Tympan/Tympan_AIC_Shield/README.md

# Tympan AIC Shield
## Add a CODEC to your Tympan with this daughter card!

This hardware design is in BETA and will be available for purchase March of 2019 at [Tympan.org](https://tympan.org/)
