Tympan/Tympan_AIC_Shield/Production/Tympan_AIC_Shield_BOM.xlsx

Item | Reference | Package | Quantity | Value | Manufacturer | Part Number | Notes
1 | C23,C2,C8,C12,C13,C24,C25,C26 | C_0402 | 8 | 2.2uF | Murata | GRT155C71A225KE13D
2 | C3,C5,C7,C10,C16,C18 | C_0402 | 6 | 0.1uF | TDK Corporation | C1005X7R1H104K050BB
3 | C4,C6,C11 | C_0402 | 3 | 10uF | Murata | GRM155C80J106ME11J
4 | C9,C17,C19 | C_0402 | 3 | 1uF | Murata | GRM155C81C105KE15D
5 | J1 | SJ-3523-SMT-TR | 1 | Phone Out | CUI Inc | SJ-3523-SMT-TR
6 | J2 | SJ-3524-SMT-TR | 1 | Mic In | CUI Inc | SJ-3524-SMT-TR-PI
7 | MIC2,MIC1 | SPM0687LR5H-1 | 2 | DNP | DNP | DNP | DNP
8 | P5,P6 | Pin_Header_Straight_1x06_Pitch2.54mm | 2 | CONN_01X06 | Samtec | SSW-106-01-G-S
9 | P3,P4,P2,P1 | Pin_Header_Straight_1x06_Pitch2.54mm | 4 | CONN_01X06 | Samtec | SSW-106-03-T-S
10 | R1,R8 | R_0402 | 2 | 4K7 | Yageo | RC0603FR-074K7L
11 | R12,R13 | C_0603 | 2 | 0R | Vishay Dale | CRCW06030000Z0EA
12 | R14,R17 | C_0603 | 2 | DNP | DNP | DNP | DNP
13 | R15,R16 | C_0603 | 2 | 2.2K | Yageo | RC0603FR-072K2L
14 | R2,R3,R4,R5,R6,R7,R9,R10 | R_0402 | 8 | 33R | Yageo | RC0402FR-0733RL
15 | U2 | UQFN-40-1EP_5x5mm_Pitch0.4mm | 1 | CODEC | Texas Instrument | TLV320AIC3206IRSBT
16 | U3 | SOT-353_SC-70-5 | 1 | Analog Switch IC | Texas Instrument | TS5A3166DCKR
