Tympan/Tympan_AIC_Shield/Tympan AIC Shield Schematic.pdf

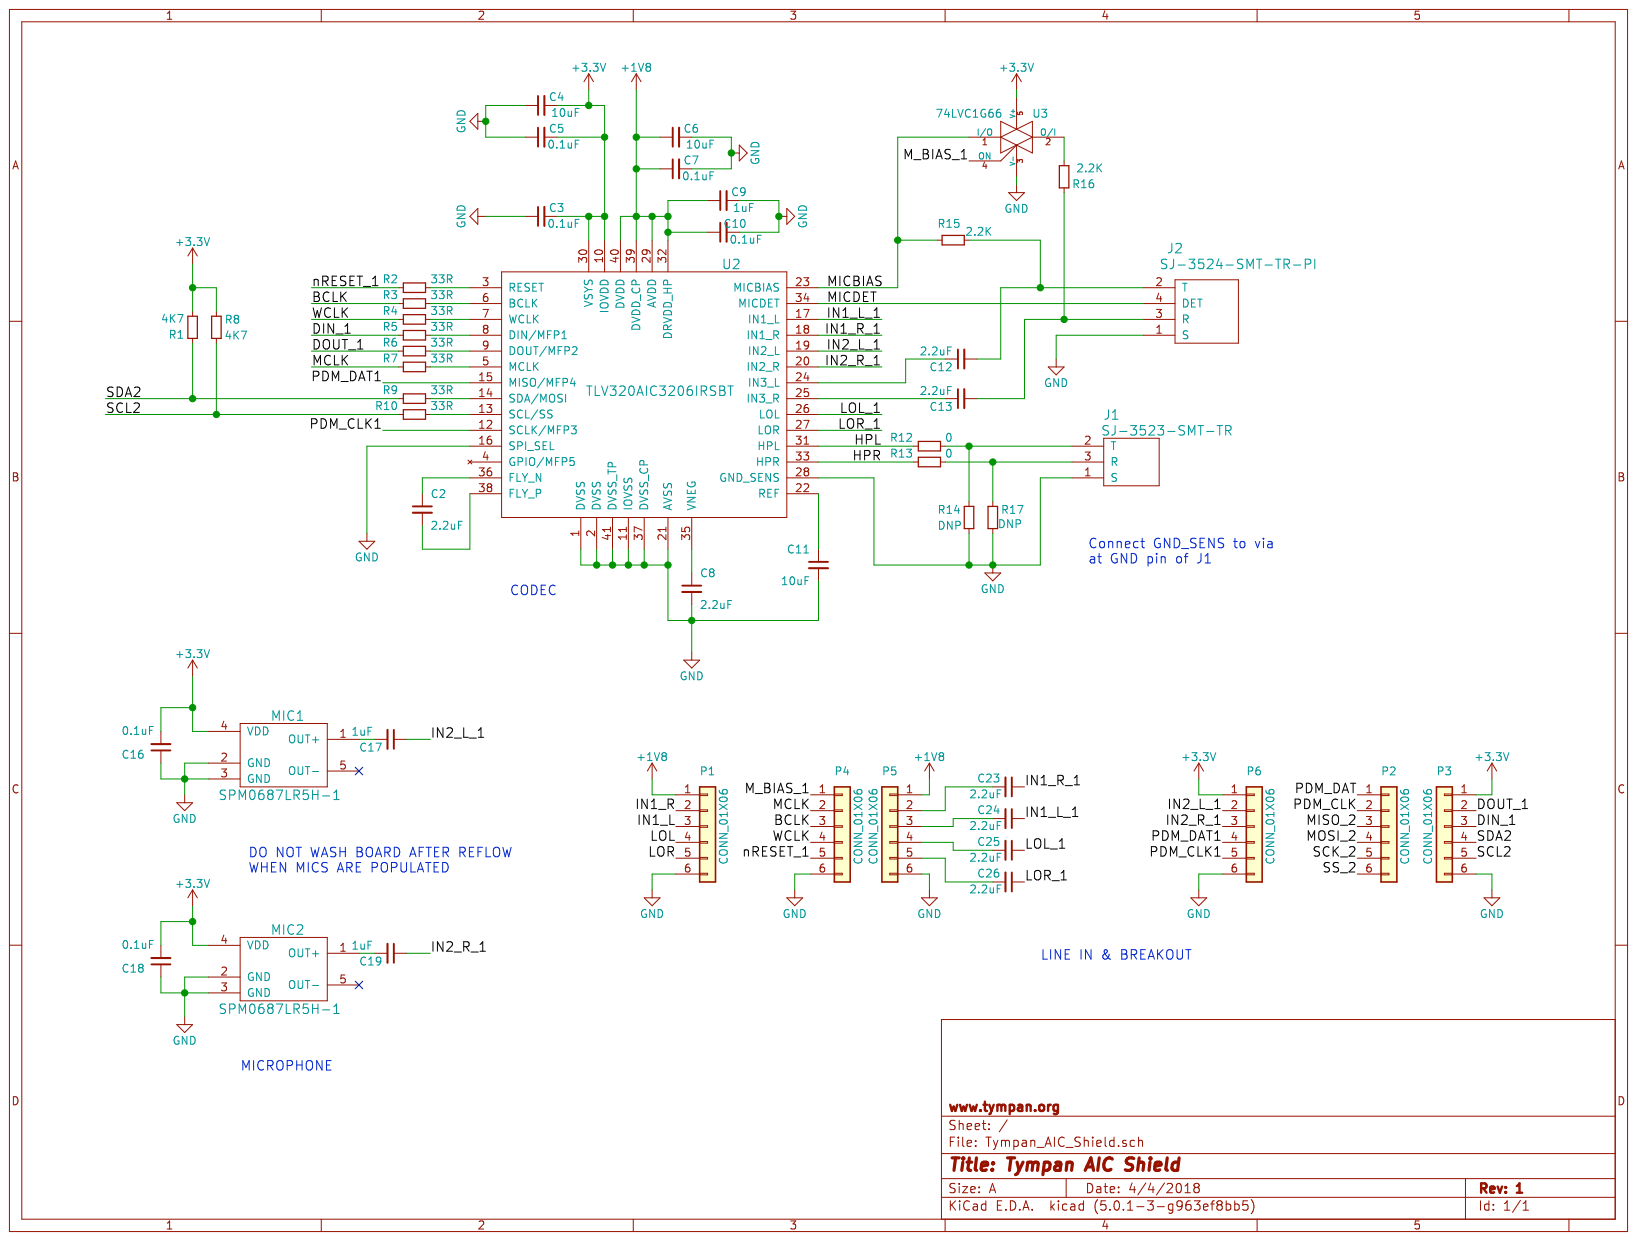
[picture p1: page 1]
