Tympan/Tympan_AIC_Shield/Tympan_AIC_Shield.kicad_pcb

## KiCad design Tympan_AIC_Shield.kicad_pcb (2019-03-19)

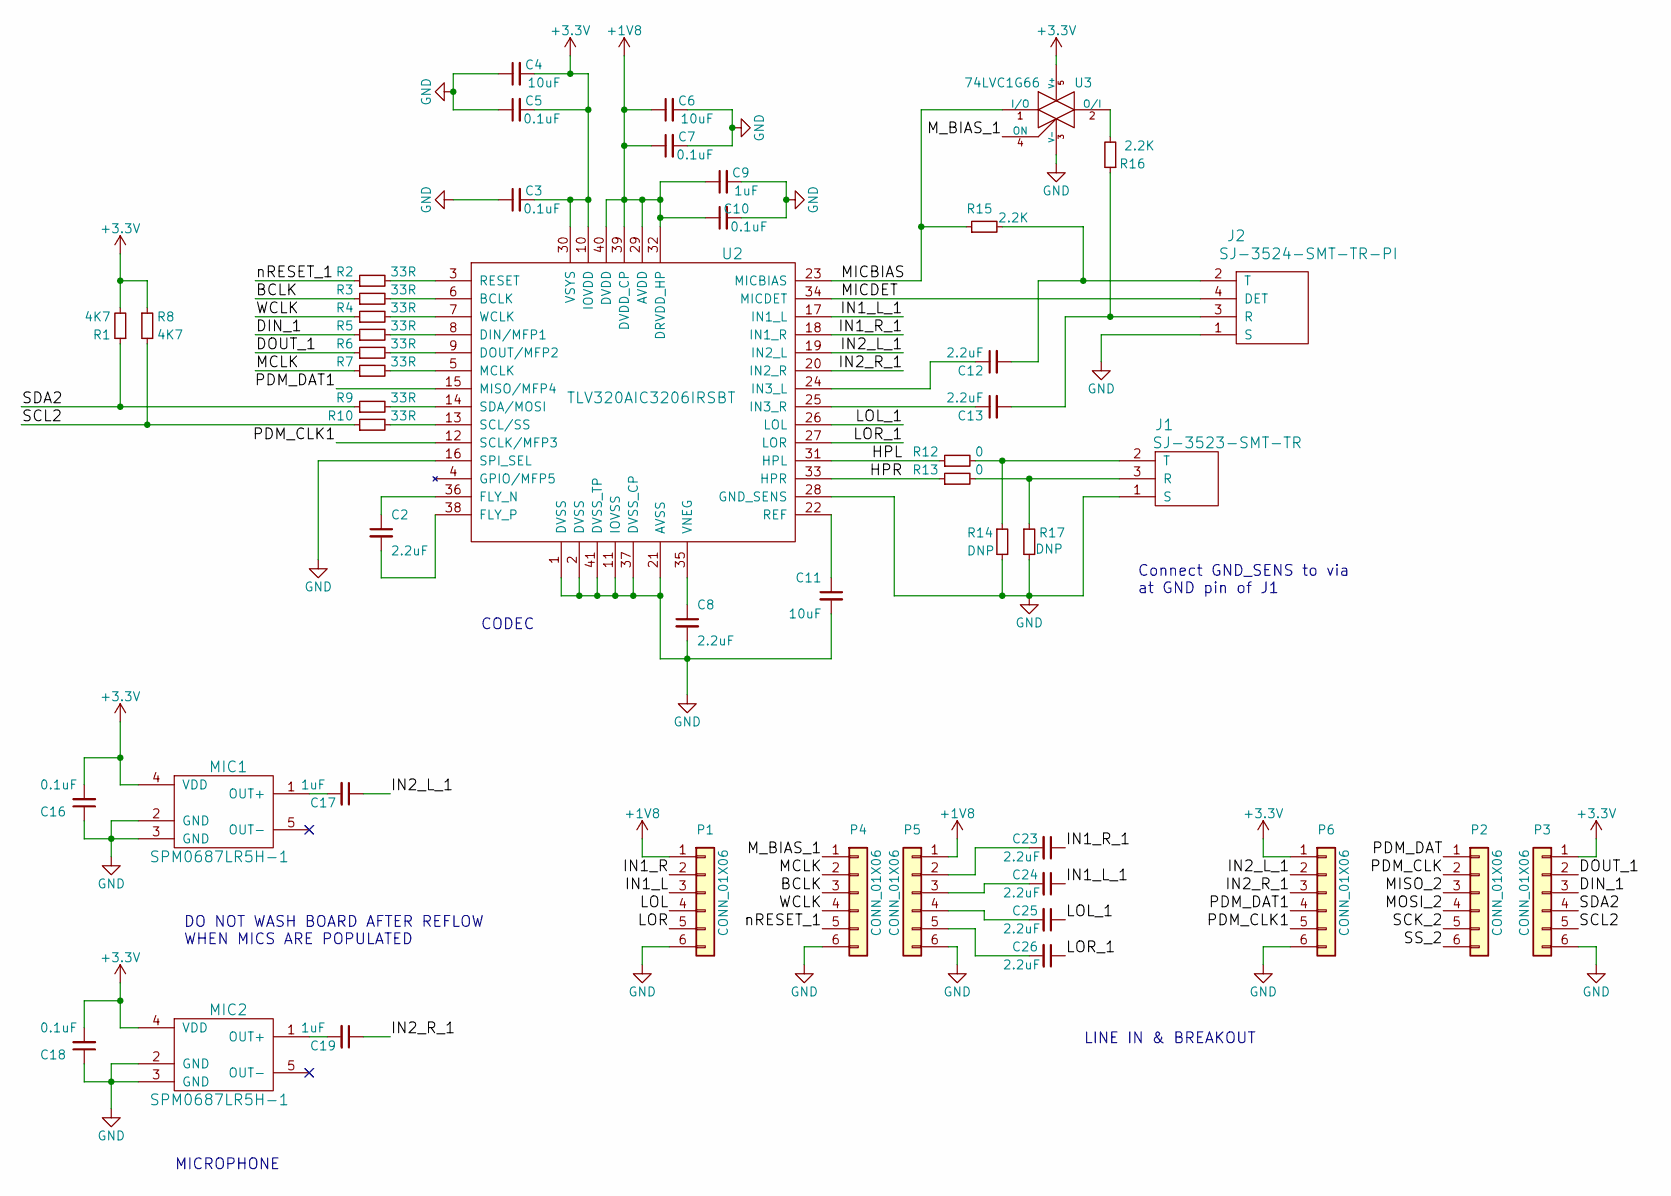
[picture p2: schematic Tympan_AIC_Shield.sch, Tympan AIC Shield]

Parts:
C2, C8, C12, C13, C23, C24, C25, C26: 2.2uF; C_0402
C3, C5, C7, C10, C16, C18: 0.1uF; C_0402
C4, C6, C11: 10uF; C_0402
C9, C17, C19: 1uF; C_0402
J1: SJ-3523-SMT-TR
J2: SJ-3524-SMT-TR-PI; SJ-3524-SMT-TR
MIC1, MIC2: SPM0687LR5H-1
P1, P2, P3, P4, P5, P6: CONN_01X06; Pin_Header_Straight_1x06_Pitch2.54mm
R1, R8: 4K7; R_0402
R2, R3, R4, R5, R6, R7, R9, R10: 33R; R_0402
R12, R13: 0; C_0603
R14, R17: DNP; C_0603
R15, R16: 2.2K; C_0603
U2: TLV320AIC3206IRSBT; UQFN-40-1EP_5x5mm_Pitch0.4mm
U3: 74LVC1G66; SOT-353_SC-70-5

Connections:
+1V8: C6.1, C7.1, C9.1, C10.1, P1.1, P5.1, U2.29 (AVDD), U2.32 (DRVDD_HP), U2.39 (DVDD_CP), U2.40 (DVDD)
+3V3: C3.2, C4.2, C5.2, C16.2, C18.2, MIC1.4 (VDD), MIC2.4 (VDD), P3.1, P6.1, R1.2, R8.1, U2.10 (IOVDD), U2.30 (VSYS), U3.5 (V+)
/BCLK: P4.3, R3.1
/DIN_1: P3.3, R5.1
/DOUT_1: P3.2, R6.1
/HPL: R12.1, U2.31 (HPL)
/HPR: R13.1, U2.33 (HPR)
/IN1_L: P1.3
/IN1_L_1: C24.1, U2.17 (IN1_L)
/IN1_R: P1.2
/IN1_R_1: C23.1, U2.18 (IN1_R)
/IN2_L_1: C17.1, P6.2, U2.19 (IN2_L)
/IN2_R_1: C19.1, P6.3, U2.20 (IN2_R)
/LOL: P1.4
/LOL_1: C25.1, U2.26 (LOL)
/LOR: P1.5
/LOR_1: C26.1, U2.27 (LOR)
/MCLK: P4.2, R7.1
/MICBIAS: R15.1, U2.23 (MICBIAS), U3.1 (I/O)
/MICDET: J2.4 (DET), U2.34 (MICDET)
/MISO_2: P2.3
/MOSI_2: P2.4
/M_BIAS_1: P4.1, U3.4 (ON)
/PDM_CLK: P2.2
/PDM_CLK1: P6.5, U2.12 (SCLK/MFP3)
/PDM_DAT: P2.1
/PDM_DAT1: P6.4, U2.15 (MISO/MFP4)
/SCK_2: P2.5
/SCL2: P3.5, R8.2, R10.1
/SDA2: P3.4, R1.1, R9.1
/SS_2: P2.6
/WCLK: P4.4, R4.1
/nRESET_1: P4.5, R2.1
GND: C3.1, C4.1, C5.1, C6.2, C7.2, C8.2, C9.2, C10.2, C11.2, C16.1, C18.1, J1.1 (S), J2.1 (S), MIC1.2 (GND), MIC1.3 (GND), MIC2.2 (GND), MIC2.3 (GND), P1.6, P3.6, P4.6, P5.6, P6.6, R14.2, R17.2, U2.1 (DVSS), U2.2 (DVSS), U2.11 (IOVSS), U2.16 (SPI_SEL), U2.21 (AVSS), U2.28 (GND_SENS), U2.37 (DVSS_CP), U2.41 (DVSS_TP), U3.3 (V-)
unnamed: C2.1, U2.36 (FLY_N)
unnamed: C2.2, U2.38 (FLY_P)
unnamed: C8.1, U2.35 (VNEG)
unnamed: C11.1, U2.22 (REF)
unnamed: C12.1, U2.24 (IN3_L)
unnamed: C12.2, J2.2 (T), R15.2
unnamed: C13.1, U2.25 (IN3_R)
unnamed: C13.2, J2.3 (R), R16.1
unnamed: C17.2, MIC1.1 (OUT+)
unnamed: C19.2, MIC2.1 (OUT+)
unnamed: C23.2, P5.2
unnamed: C24.2, P5.3
unnamed: C25.2, P5.4
unnamed: C26.2, P5.5
unnamed: J1.2 (T), R12.2, R14.1
unnamed: J1.3 (R), R13.2, R17.1
unnamed: R2.2, U2.3 (RESET)
unnamed: R3.2, U2.6 (BCLK)
unnamed: R4.2, U2.7 (WCLK)
unnamed: R5.2, U2.8 (DIN/MFP1)
unnamed: R6.2, U2.9 (DOUT/MFP2)
unnamed: R7.2, U2.5 (MCLK)
unnamed: R9.2, U2.14 (SDA/MOSI)
unnamed: R10.2, U2.13 (SCL/SS)
unnamed: R16.2, U3.2 (O/I)

Notes on the sheet:
MICROPHONE
CODEC
Connect GND_SENS to via at GND pin of J1
LINE IN & BREAKOUT
DO NOT WASH BOARD AFTER REFLOW WHEN MICS ARE POPULATED

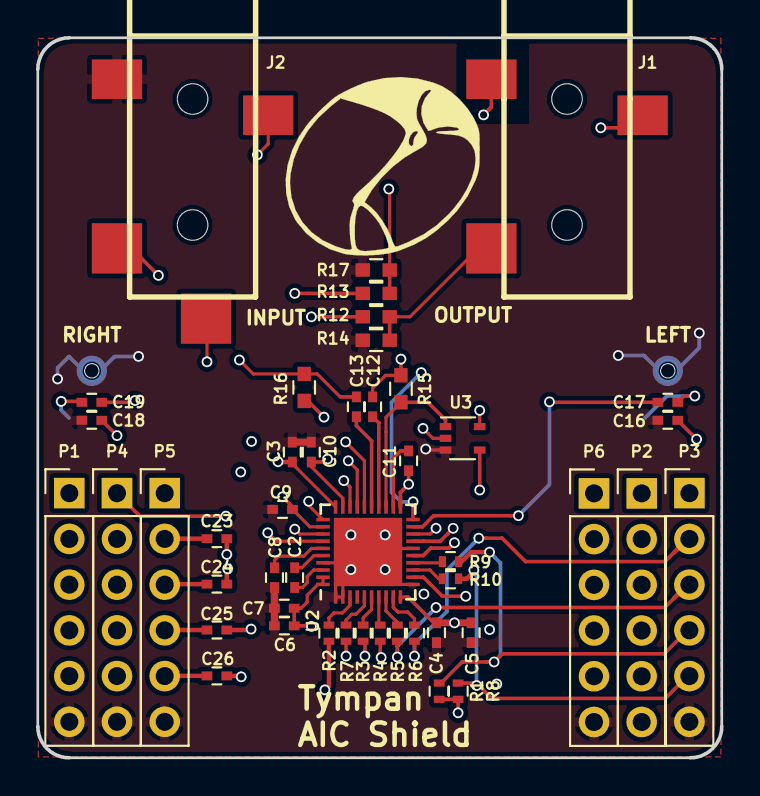
[picture p3: board Tympan_AIC_Shield.kicad_pcb from above]

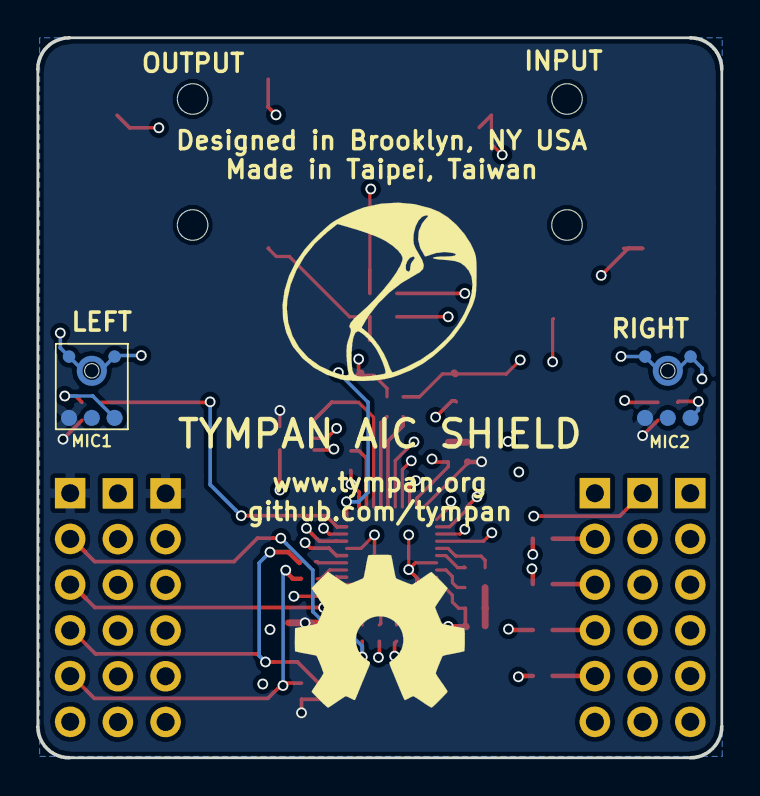
[picture p4: board Tympan_AIC_Shield.kicad_pcb from below]

Board: 4 copper layers, 38.0 x 40.0 mm, 48 parts (2 on the bottom side), 49 nets.
