Tympan/Tympan_AIC_Shield/(commit log)

2019-03-07 Added I2C pullups, moved caps to front layer
    I2C needed pullup Rs
    Tied in to the 1V8 and GND on P1
    Moved caps to front layer for single sided load when not populating mics
2019-03-18 Cleaned silk. Need to breakout PDM connections
    [Tympan_AIC_Shield.kicad_pcb, Tympan_AIC_Shield.sch]
2019-03-19 added PDM breakout
    [Tympan_AIC_Shield-B.Cu.gbr, Tympan_AIC_Shield-B.Mask.gbr, Tympan_AIC_Shield-B.Paste.gbr, Tympan_AIC_Shield-B.SilkS.gbr, Tympan_AIC_Shield-Edge.Cuts.gbr, Tympan_AIC_Shield-F.Cu.gbr, Tympan_AIC_Shield-F.Mask.gbr, Tympan_AIC_Shield-F.Paste.gbr]
